RomainCocogne/POLYTECH_PEIP2_ARDUINO_PROJET/README.md

Polytech

Ce projet est réalisé dans le cadre de la formation de prépa intégrée de Polytech'Nice Sophia

# STROBOGLOVE
projet arduino time control glove 


<!--https://i.makeagif.com/media/1-31-2017/7Gys2-.gif pour une meilleur qualité mais qui marche pas avec l'HTML-->

## Présentation du projet
L'objectif de ce projet est de réaliser une paire de gants capable de "contrôler" le temps grâce à l'effet stroboscopique.

Voici un rendu du produit final: 

time control glove

## <a href="http://www.youtube.com/watch?feature=player_embedded&v=jR2pRvadDSw " target="_blank">Vidéo de démonstration du stroboglove</a>

***

Nous utilisons deux gants en communication bluetooth; l'un se charge des flashs lumineux et l'autre se charge du contrôle de la fréquence.

## Liste du matériel
### Structure 	
. Gants	Non payé
. Brassard	4.90
. Pâte thermique	5.24
. Lentilles optiques	2.82
. Plaque de cuivre	Non payé
### Electronique 	
. 2 Arduino (Nano/Mini Pro)	2x4.39
. Accéléromètre	Non payé
. Résistances 100 et 10k	Non payé
. MOSFET	0.93
. Flex Sensors	2x6.82
. LED blanche 100W	6.83
### Alimentation 	
. Batterie 11,1V - 12V +3A 1500 mAh	Non payé
. Batterie 8V	Non payé
. Convertisseur Boost DCDC (12V to 34V)	2.79
### Transfert de données :	
. Bluetooth HM-10	Non payé
### Objet en rotation	
. Moteur continu ou pas à pas	Non payé
. Horloge	Non payé
### TOTAL	45.93 €
