RomainCocogne/POLYTECH_PEIP2_ARDUINO_PROJET/doc/QuentinCOMBAL.md

# Cahier de suivi du projet de Quentin Combal

* ### Séance du 22 Décembre 2017 

Formation du groupe avec Romain Cocogne. Nous avions déjà prévu de faire un sujet mettant en scéne [*l'effet stroboscopique*](https://fr.wikipedia.org/wiki/Effet_stroboscopique).

L'effet stroboscopique est une illusion d'optique qui donne l'impression de ralentir, voire arreter complétement un objet en mouvement.

Aprés quelques recherches, nous nous sommes mis d'accord pour utiliser cet effet en le controllant à l'aide de deux gants.

* ### Séance du 12 Janvier 2018

Nous avons etabli une planification des taches sur un diagramme de Gantt. Nous avons egalement esquissé un schema de fonctionnement, et dréssé la liste des composants. 

* ### Séance du 18 Janvier 2018
Nous avons préparé la presentation orale de fin Janvier, envoyé une liste d'achat de composants à M.Masson, et réalisé un schema visuel de notre montage électronique avec le logiciel Fritzing. 
Nous avons également trouvé, dans les stocks de la salle elec, une batterie adéquate pour l'alimentation du premier gant.    

* ### Séance du 23 Janvier 2018
Nous avons présenté notre projet au groupe. 

* ### Séance du 7 Février 2018
Reçu les composants
Tests avec la LED : tension d'alimentation, luminosité, frequence de presistence retinienne.
Test des valeurs de resistance du flex sensor

* ### Entre le 7 Févrirer et le 16 Mars 2018
Mise en place du montage Arduino + DCDC Converter + LED. Tests avec ce montage pour determiner la bande de fréquences atteignable avec la LED.  

* ### Séance du 16 Mars 2018
Nous avons fait des tests avec l'accelerométre numérique et les modules bluetooth.
Nous avons également mis à jour notre diagramme de Gantt.

* ### Séance du 29 Mars 2018
Nous avons presenté notre avancement dans une presentation de mi-parcours. Nous avons egalement continué nos tests avec le bluetooth et l'accelerométre.

* ### Séance du 5 Avril 2018
Tests avec les flex sensors et les modules bluetooth. Finition du code pour l'accelerométre.

* ### Séance du 9 Avril 2018
Peaufinage du code comprenenant l'accelerométre, les flex sensors, et la LED. Debut d'un prototype avec le montage sur pcb du circuit de droite. Deuxiéme commande de composants.  

* ### Séance du 9 Mai 
Changment de matériel Bluetooth : On remplace les HC-05 par des HM-10 qui fonctionnement mieux 
Les codes des deux gants sont prets, il ne reste plus qu'a attendre les arduinos nano commandées et tout assembler.

* ### Du 21 au 31 Mai 
Assemblage et correction de quelques problémes de timing au niveau de libraries Arduino. Tournage de la vidéo de présentation.
