RomainCocogne/POLYTECH_PEIP2_ARDUINO_PROJET/doc/RomainCOCOGNE.md

# Cahier de suivi de projet Romain Cocogne

## Séance du 22 décembre

J'ai formé mon groupe avec Quentin Combal. Nous avons décidé de réaliser le **STROBOGLOVE**. Il s'agit d'une pair de gants qui donnent l'illusion de mannipuler le temps grâce à l'effet stroboscopique.

Nous avons trouvé un projet existant qui fonctionne sur un gant, mais nous avons décidé d'en faire une pair afin de respecter le cahier des charges (au moins une communication sans fil).

Lien vers le projet existant: http://www.instructables.com/id/DIY-Time-Control-Machine/ 

## Séance du 12 Janvier

Esquise du schémas électronique. J'ai commencé à lister les composants. On a hésité entre une arduino nano ou mini pro. On a aussi regardé si il était réalisable de n'utiliser qu'une seule arduino (au final c'est un peu dur).

## Séance du 18 Janvier

J'ai préparé le ppt de la présentation du 23 janvier. j'ai finalisé la liste des composants. Il ne reste plus qu'a l'envoyer à Mr Masson.

## Séance du 23 Janvier

On a fait la première présentation orale. On a réfléchit à des idées pour le réglage macro du stroboscope; L'idée retenue est utiliser les flex sensors pour régler en macro quand la main est fermée, sauf deux  doigts.

## Séance du 7 Février
On a reçus la majorité des composants.
On les a un peu testé notamment la LED et les flex sensors:
On a mesuré la consommation de la LED, les fréquences de fonctionnement.
On a mesuré les valeurs des flex sensors, tendus et pliés.

## Entre le 7 Févrirer et le 16 Mars
On a réalisé le montage de la main droite consistant à la batterie, la LED, et l'arduino. il ne reste plus que le module bluetooth sue cette main. On a testé les fréquences de fonctionnement de la LED et on a remarqué que le baud rate de l'arduino limitait la fréquence max de clignotement.  

## Séance du 16 Mars 
Quentin a travaillé sur l'accéléromètre, moi j'ai travaillé sur le bluetooth et j'ai essayé de le faire fonctionner. J'ai pris un HC-05 et un HC-06.
Nous avons également mis à jour notre diagramme de Gantt.

## Séance du 29 Mars
Nous avons presenté notre avancement dans une presentation de mi-parcours. J'ai continué de travailler sur le bluetooth. impossible de le faire fonctionner et je trouve pas la source du problème. Si cela continue je vais demander de l'aide à un professeur pour pouvoir avancer.

## Séance du 5 Avril
Quentin a fini de travailler sur l'accéléromètre. Je n'arrive toujours pas a faire fonctionner le bluetooth. On a aussi travaillé sur les flex sensors.

## Séance du 9 Avril
On a commandé de nouveaux composants. j'ai soudé le circuit de la main droite sur PCB.
On a travaillé sur des objets ludiques pour la démo.

## Séance du 2 Mai
J'ai demandé à Mr Ferrero de l'aide pour le bluetooth. Il m'a donné d'autres modules. Des HM-10. Ceux-ci ont l'air de marché, même si on s'est rendu compte qu'il s'agissait de contrefaçon. Je vais travailler avec ça maintenant.

## Séance du 9 Mai
On a avancé dans le montage final, même si on attend encore des composants clés (comme les arduino nano).
J'ai presque fini le code du bluetooth.

## Du 21 au 31 Mai
C'est le rush des dernières semaines. On a réussi à finir le hardware, malgré quelques problèmes au niveau des arduino nano (des contrefaçon). Il reste à corriger quelques bugs lociels et à préparer le rapport.
