RomainCocogne/POLYTECH_PEIP2_ARDUINO_PROJET/presentation/Presentation 2/Presentation_2.odt

Rappels sur le projet

Avancements :

la plupart des composants ont été reçus (Manque des flex sensors et les deux arduino nano)

La partie du montage qui contient la LED et complète et fonctionnelle. L'autre partie est

Les tests avec l'effet nous ont permis de définir les limites du projet (freq min et max, sur quels objets ? ) → Fréquence visible à l’œil nu : entre 70 Hz et 100Hz

→ 500Hz Max

Données du flex sensor, de la consommation du circuit.

Estimation de la durée de la batterie sans recharge (jusque là, pas eu besoin de recharger)

Réussites :

L'effet fonctionne, la mise en place est un succés

Mise en service des modules flex sensors et accelerométres reussie

Module bluetooth opérationnel, mais encore quelques complications

Difficultés :

Limitations d'arduino : Le Baud rate du bluetooth ( 250000 max) limite la fréquence à 500 Hz max

Difficulté a comprendre le code de l’accéléromètre : Filtre de Kalman, Bus I²C

Changements :

Trouver une bonne esthétique au produit.

On utilisera pas de potentiomètre, reglage en levant un ou deux doigts.On exploite les flex sensors

Dans le diagramme : Peaufinage des taches à venir, possibles car on s’était laissé de la marge , ajout de « l'étude des modules » comme tâche après avoir eu des difficultés → ça a pris du temps.

Objets ludiques : Horloge avec moteur

Batterie 2 : on a des candidats

Conclure sur le ressenti

Script :

Bonjour à tous, dans cette présentation nous allons vous montrer l'evolution de notre projet stroboglove.

Un petit rappel sur notre projet

L'etat d'avancement du projet : voici le schéma actuel. La partie droite est quasi-complète et fonctionne ( L'effet visuel est observable, la frequence est facilement manipulable). La partie gauche est déjà bien avancée (accélérométre + flex sensor OK). → Qu'est-ce qui ne fonctionne pas encore ?

Voici un exemple de rendu actuel en vidéo. L'effet n'est pas constant car perd en vitesse de rotation, objet pas suffisamment adapté mais l'effet est déjà bien visible.

Limitations : On a fait des tests des frequences min et max :

→ Visibilté à l'oeil nu : limite entre 70Hz et 100Hz

→ Limitations d'arduino : frequence max à 500Hz, on soupçonne que c'est dû au baud rate (utilisé pour le debug et le module bluetooth)

Données du flex sensor, de la consommation du circuit.

Estimation de la durée de la batterie sans recharge (jusque là, pas eu besoin de recharger)

Nos difficultés : étude des modules et des codes trouvés sur internet → Pas toujours facile

→ A posé des dificultés

ex : Filtre Kalman, récupérations des données de l’accéléromètre, modules bluetooth

Une mise à jour de notre matériel et de nos composants : En vert les composants que l'on à déjà, la majeure partie du matériel est déjà présente, il manque quelques flex sensors, la plaque de cuivre, etc... Plus de potentiomètre → on exploite les flex sensors.

Et il faudrait plus d'objets ludiques, par exemple une horloge mécanique à laquelle on fixerai un moteur pour faire tourner les aiguilles rapidement.

Nos objectifs principaux restent les mêmes : le fil rouge est toujours le même

Par contre, changements au niveau de l’esthétique et ergonomie : ajout de strips led comme indicateurs (pour le bluetooth, mode macro/micro, etc...)

Nous avons (peaufiné) notre diagramme de Gantt → les tâches jusqu'à aujourd'hui sont restées inchangées mais les tâches à venir ont été précisées suite à nos difficultées → « Étude des modules » par exemple

Changement possible car on s'est laissé de la marge.

Conclusion : notre ressenti, on est confiants pour la suite
