RomainCocogne/POLYTECH_PEIP2_ARDUINO_PROJET/presentation/Presentation finale/présentationfinale.pdf

# STROBOGLOVE

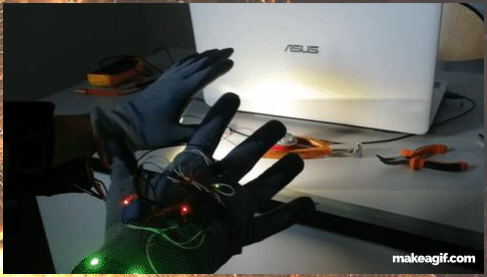
[picture p19: figure]

Polytech Nice-Sophia 2018

## COMBAL Quentin COCOGNE Romain

# sommaire

# •Objectifs du projet

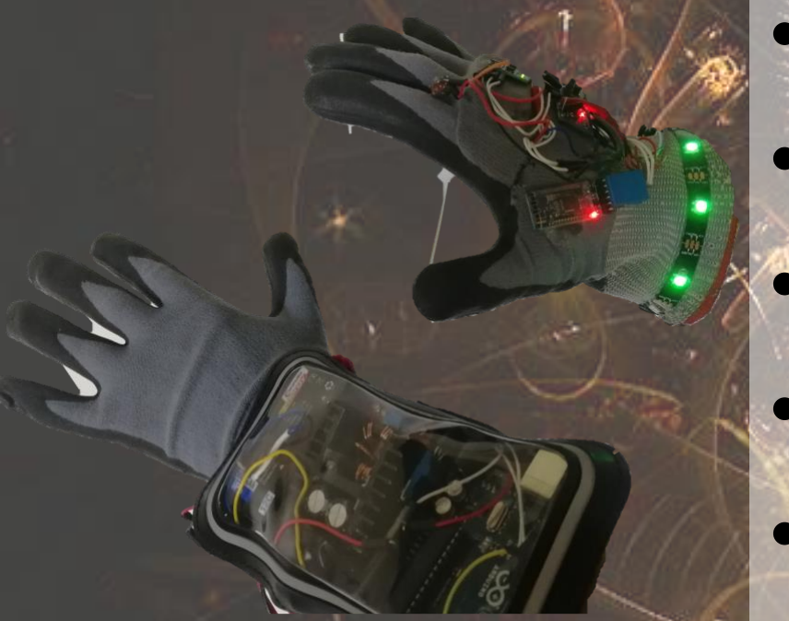
[picture p20: figure]

# - Principe de fonctionnement •Organisation du projet - Matériel et composants •Difficultés - Conclusion

# Objectifs

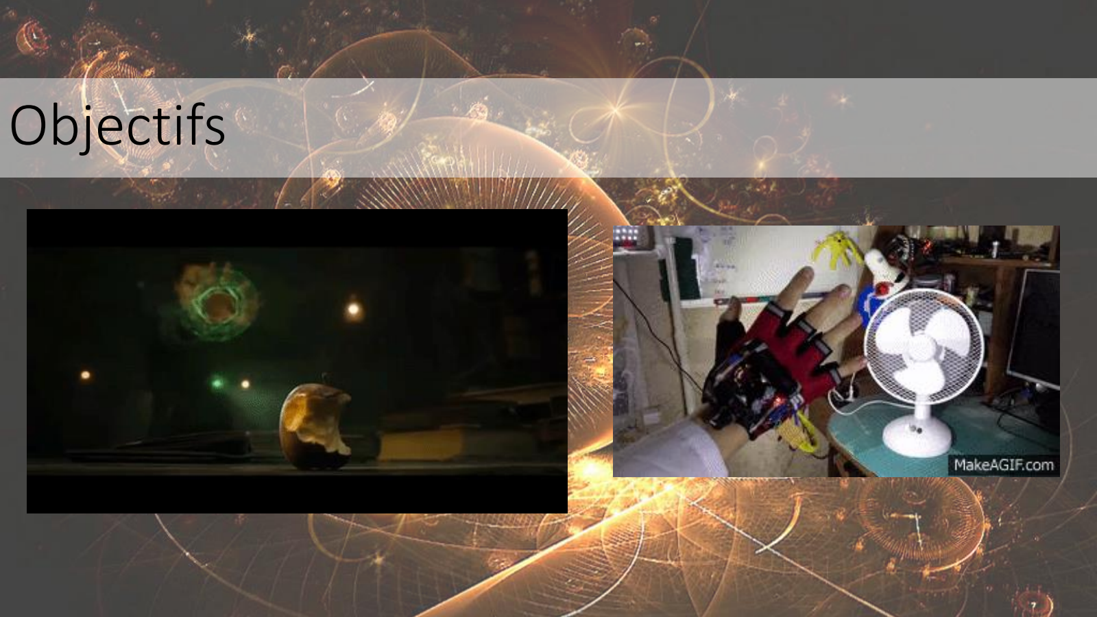
[picture p21: page 3]

# Rendu final

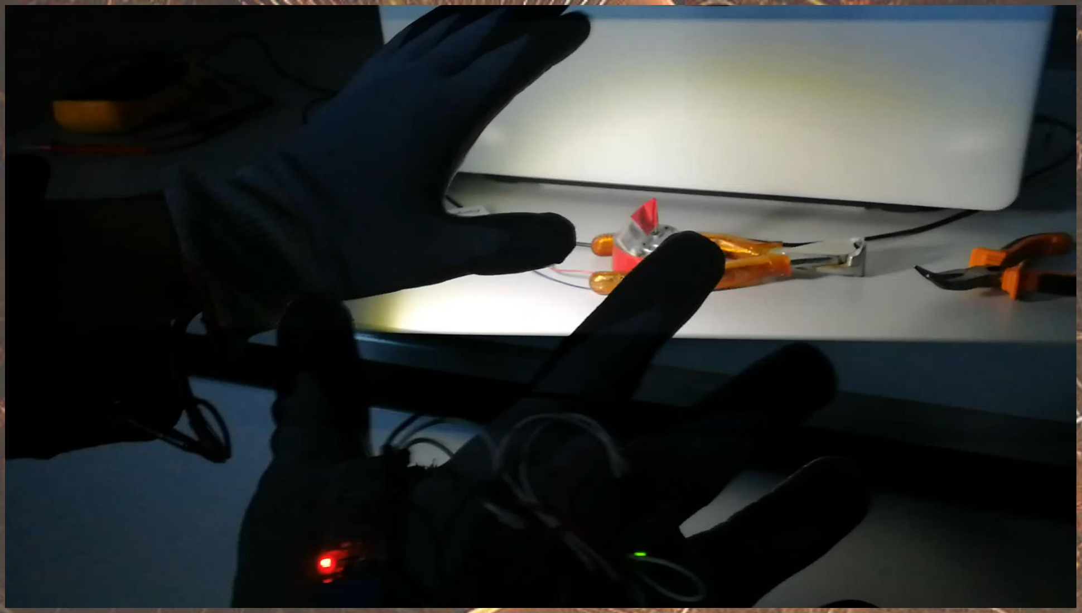
[picture p22: figure]

# Principe de fonctionnement

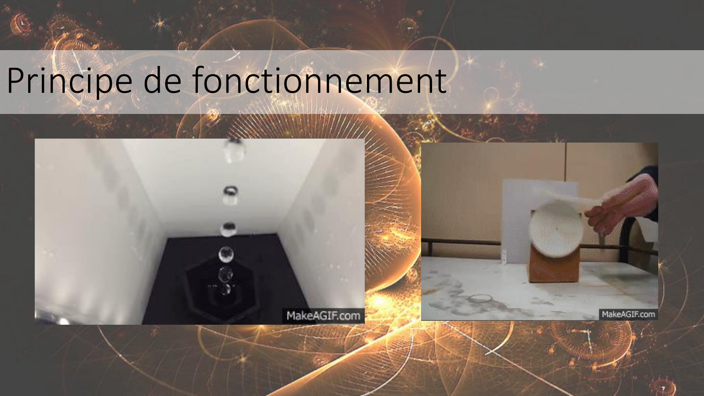
[picture p23: page 5]

# Principe de fonctionnement

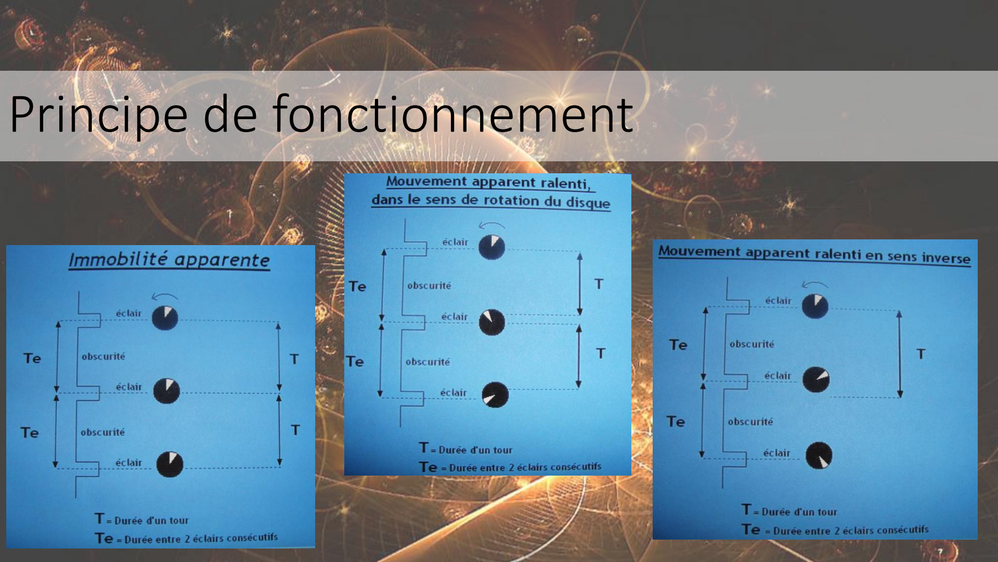
[picture p24: page 6]

# Organisation du projet

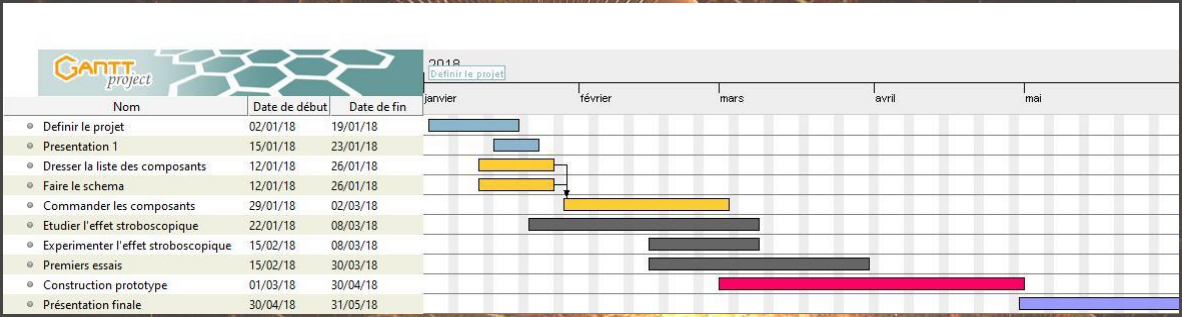
[picture p25: figure]

# Matériel et composants

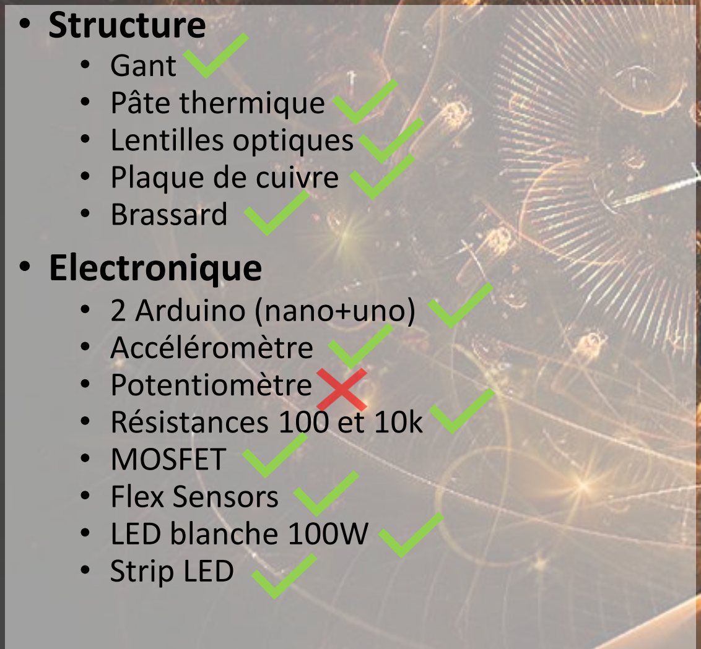
[picture p26: figure]
• Structure • Gant • Pâte thermique • Lentilles optiques • Plaque de cuivre • Brassard • Electronique • 2 Arduino (nano+uno) • Accéléromètre • Potentiomètre • Résistances 100 et 10k • MOSFET • Flex Sensors • LED blanche 100W • Strip LED
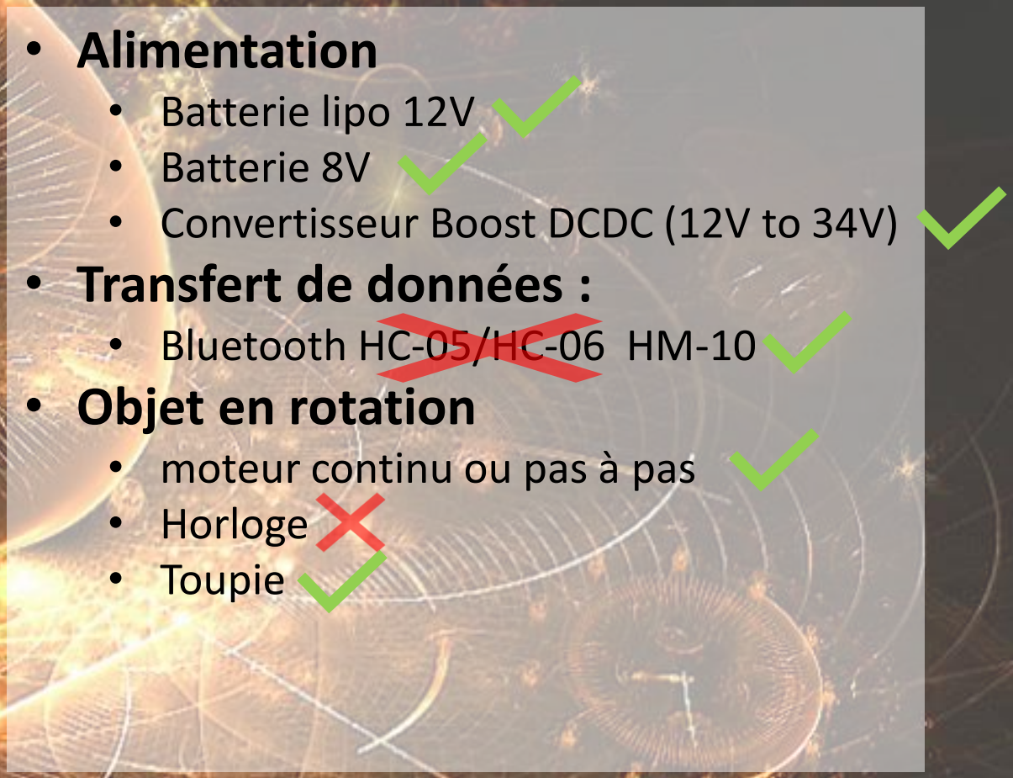
[picture p27: figure]
• Alimentation • Batterie lipo 12V • Batterie 8V • Convertisseur Boost DCDC (12V to 34V) • Transfert de données : • Bluetooth HC-05/HC-06 HM-10 • Objet en rotation • moteur continu ou pas à pas • Horloge • Toupie

# Schéma

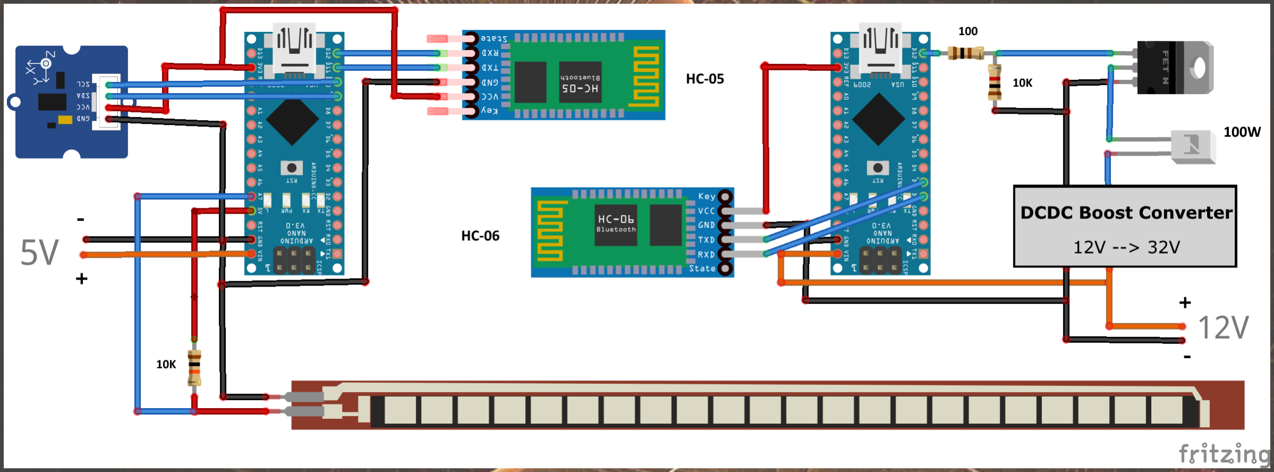
[picture p28: figure]

# Difficultés

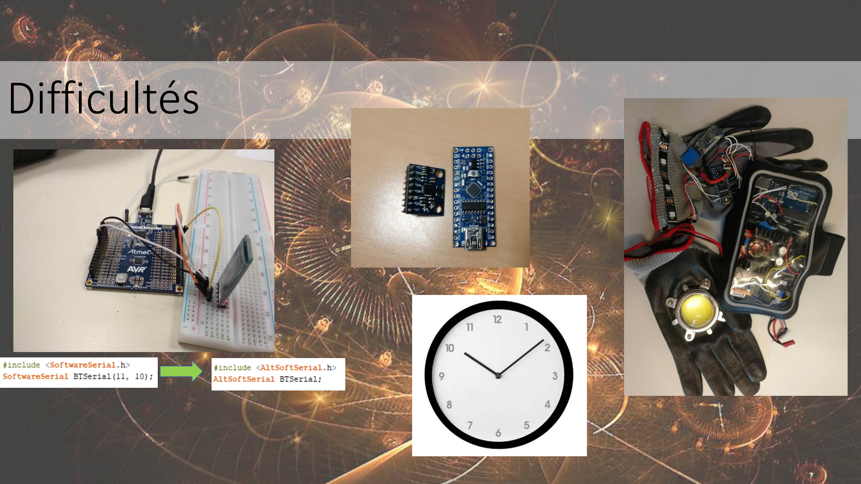
[picture p29: page 10]

# Conclusion

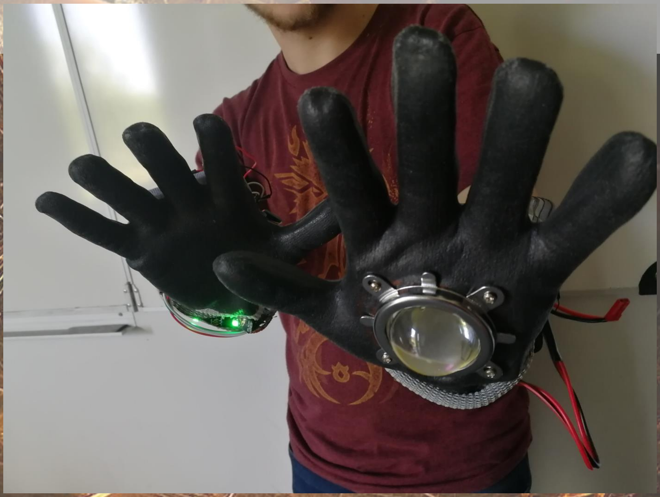
[picture p30: figure]

## - http://lesillusionsdoptique-tpe.e-monsite.com/pages/la-

stroboscopie-qu-est-ce-que-c-est.html (http://lesillusionsdoptique-tpe.e-monsite.com/pages/la-stroboscopie-qu-est-ce-que-c-est.html)

## - http://www.makeagif.com - http://www.instructables.com/id/DIY-Time-Control-Machine/

# Sources
