RomainCocogne/POLYTECH_PEIP2_ARDUINO_PROJET/presentation/Presentation 2/présentation2.pdf

STROBOGLOVE | Présentation mi-parcours

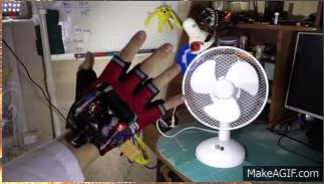
[picture p31: figure]

Polytech Nice-Sophia 2018

## COMBAL Quentin COCOGNE Romain

# Rappel du projet

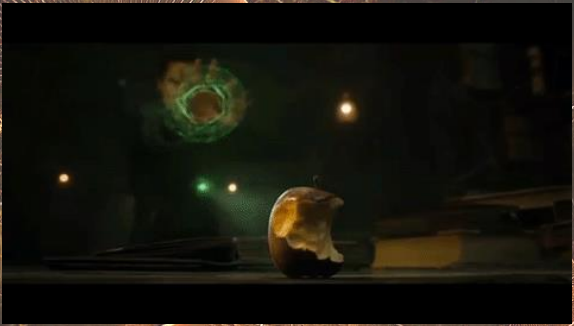
[picture p32: figure]

# sommaire

# - Avancement, réussite et difficulté - Matériel - Changement des objectifs - Retour sur planning

# Avancement, réussite et difficulté


# Avancement, réussite et difficulté

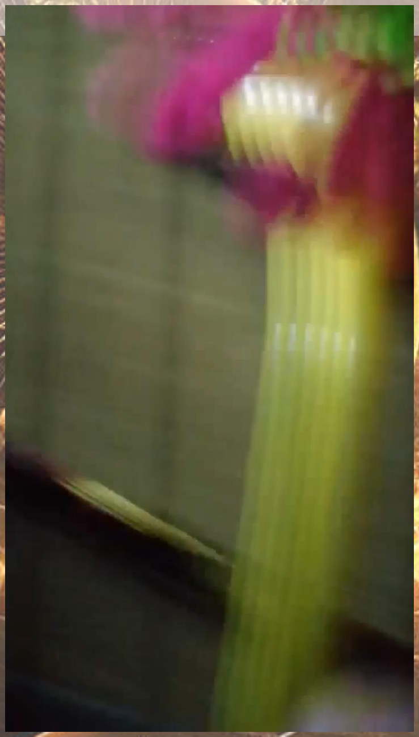
[picture p33: figure]

# Avancement, réussite et difficulté

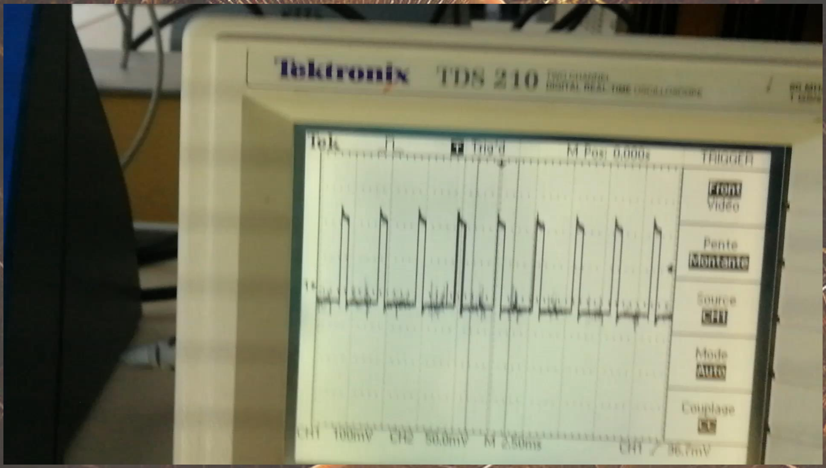
[picture p34: figure]

# Avancement, réussite et difficulté

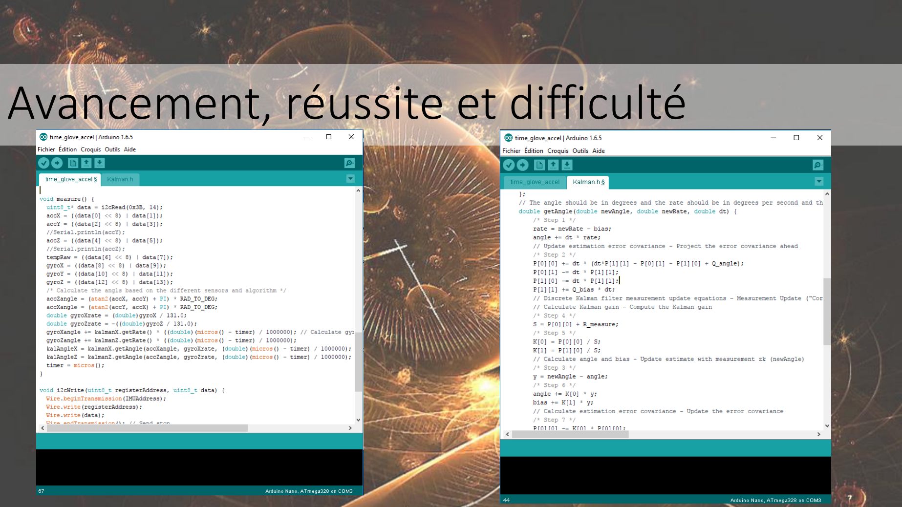
[picture p35: page 7]

### - Structure

- Gant
- Pâte thermique
- Lentilles optiques
- Plaque de cuivre

### - Electronique

- 2 Arduino (Nano/Mini Pro)
- Accéléromètre
- Potentiomètre
- Résistances 100 et 10k
- MOSFET
- Flex Sensors
- LED blanche 100W
- (LED couleur)

# Matériel et composants

### - Alimentation

- Batterie lipo 11,1V - 12V +3A 1500 mAh
- 2éme (batterie moins puissante)
- Convertisseur Boost DCDC (12V to 34V)

### - Transfert de données :

- HC-05 et HC-06

### - Objet en rotation

- moteur continu ou pas à pas
- Horloge
- Toupie

# Changement des objectifs

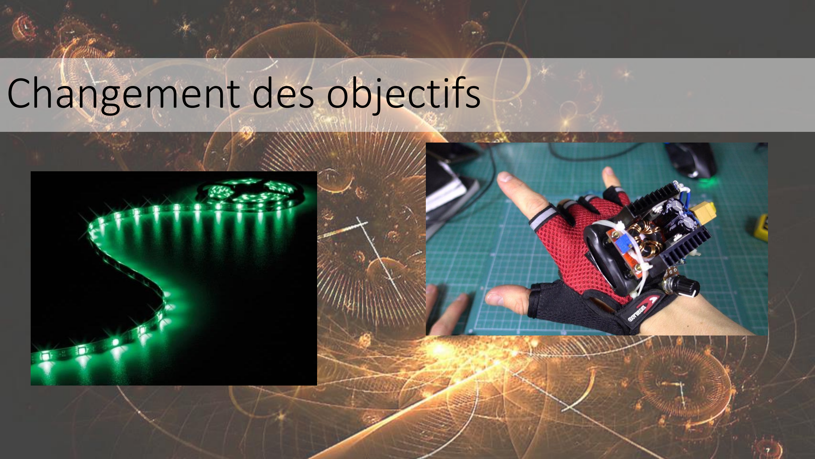
[picture p36: page 9]

# Organisation du projet

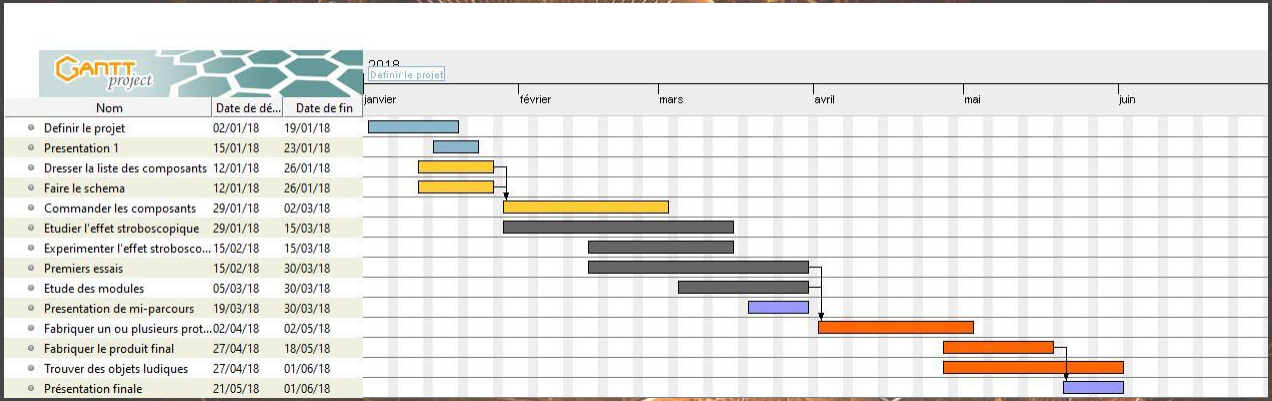
[picture p37: figure]
