RomainCocogne/POLYTECH_PEIP2_ARDUINO_PROJET/presentation/Presentation 1/présentation1.pdf

# STROBOGLOVE


Polytech Nice-Sophia 2018

## COMBAL Quentin COCOGNE Romain

# sommaire

# - Pourquoi ce projet ? - Principe de fonctionnement - Matériel et composants •Organisation du projet - Conclusion

# Pourquoi ce projet ?

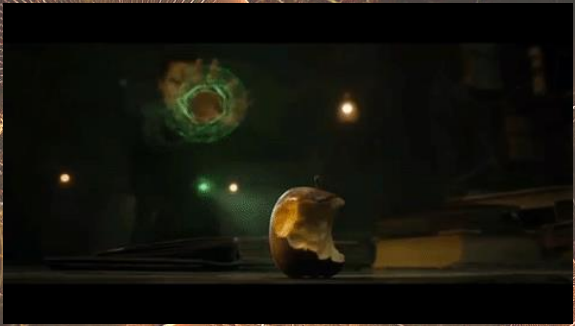
[picture p38: figure]

# Principe de fonctionnement


# Principe de fonctionnement


# Principe de fonctionnement


### - Structure

- Gant
- Pâte thermique
- Lentilles optiques
- Plaque de cuivre

### - Electronique

- 2 Arduino (Nano/Mini Pro)
- Accéléromètre
- Potentiomètre
- Résistances 100 et 10k
- MOSFET
- Flex Sensors
- LED blanche 100W

# Matériel et composants

### - Alimentation

- Batterie lipo 11,1V - 12V +3A 1500 mAh OK
- 2éme (batterie moins puissante)
- Convertisseur Boost DCDC (12V to 34V)

### - Transfert de données :

- Bluetooth

### - Objet en rotation

- moteur continu ou pas à pas
- objet ludique
- Horloge
- Toupie

# Organisation du projet


# Conclusion

https://youtu.be/rj9L1_-AzMc?t=19s

## - http://lesillusionsdoptique-tpe.e-monsite.com/pages/la-

stroboscopie-qu-est-ce-que-c-est.html (http://lesillusionsdoptique-tpe.e-monsite.com/pages/la-stroboscopie-qu-est-ce-que-c-est.html)

## - http://www.makeagif.com

# Sources
