RomainCocogne/POLYTECH_PEIP2_ARDUINO_PROJET/presentation/Presentation finale/PresentationFinale.odt

Explication du projet : Objectifs, motivations,...

Expliquer notre avancement final par rapport au planning prévu

Comparaison rendu attendu / rendu final. Gif de la vidéo qu'on a pris

Explication du principe et des rôles de chaque gant.

Description des fonctionnalités : Modes Macro/Micro, communication bluetooth, Strips LEDs indicatives, stabilité de la frequence grace à Kalman, activation grace à un mouvement de la main

Parler des limites de frequence

Résume du materiel, explication du rôle de chaque composant

Resumer l'ordre d'acquisition des composants ?

Dire quels composants ont été changés (HC-06 en HM-10, Arduino Nano en Uno)

Explication du schéma

Explication des difficultés : Exploitation de l'accelerométre, du filtre de Kalman, problémes avec les modules bluetooth, problémes avec la library Software Serial,, probléme de la nano defectueuse, probléme d'espace sur le gant

Perspectives : Ce qui reste à faire, ce qu'il faudrait ajouter ou améliorer (améliorer l'aspect visuel en camouflant les composants et fils, trouver des meilleures batteries, idée de la maille de piles plates, amélioration du confort utilisateur)

Ce que nous aurions aimer faire (l'horloge rapide pour objet ludique)

On aimerait pouvoir garder les gants pour les améliorer de notre coté

Utilisation de l'objet à des fins divertissantes ou scientifiques

Conclusion : Ce que ce projet nous a appris

Script :

Bonjour à tous, aujourd'hui nous allons vous présenter notre projet qui s'intitule StroboGlove. Nous allons vous parler de son développement, et nous allons vous présenter le produit final.

Nous allons d'abord vous parler de l'idée et des objectifs de notre projet, ensuite nous vous expliqueront le principe de fonctionnement, nous dresserons le matériel et nous détaillerons le rôle de chaque composant, enfin nous vous parlerons des difficultés rencontrées et de ce que nous a appris ce projet.

Tout d'abord, d'où nous est venu l'idée de ce projet ? Elle vient de cette scène de docteur strange, nous voulions recréer l'effet en vrai. Nous sommes tombés sur cette vidéo youtube qui exploitait l'effet Stroboscopique. Nous avons donc pensé à utiliser le même principe pour notre projet, mais en personnalisant le design et en ajoutant des fonctionnalités.

Voici donc le rendu final de notre projet

Parler des différentes fonctionnalités : Deux gants, Strip LEDs, Deux modes de reglages en pliant les doigts

Transistion : Ce projet se base donc sur l'effet stroboscopique

Reexpliquer ce qu'est l'effet Stroboscopique

Expliquer le rôle de chaque gant, les personnalisations que l'on a apportées

Transistion : Ce projet a demandé une organisation considérable, voici comme nous avons planifié les différentes tâches

Parcourir le diagramme en expliquant les différentes étapes

Transition : On vous a parlé de la liste des matériaux, la voici

Parcourir la liste des matériaux en expliquant leur rôle

Et voici le schéma fonctionnel du projet

Résumer les rôles de chaque partie du schéma. Expliquer quel composant va où

Expliquer les changements de certains composants

Transition : Certains composants ont été sources de problèmes et de difficultés

Tout d'abord avec une Arduino Nano probablement défectueuse, après avoir passé plusieurs jours a essayer de la faire fonctionner, il a fallu en recuperer une autre en urgence

Tout comme les HC-06, impossible de les faire fonctionner correctement → Remplacés par des HM-10

pb de place (brassard)

Manque d'objets ludiques malgré nos efforts pour confectionner une horloge qui tourne vite

Enfin, des difficultés sur le plan logiciel : Exploitation des données de l’accéléromètre, filtre de Kalman, problémes de stabilité dus à la Library Software Serial

Transition : Mais au final, nous avons su faire face aux difficultés et nous avons pu résoudre la majorité de nos problèmes

Conclusion : Ce qu'on a appris , les améliorations qu'on aimerait faire (confort, gestion de l'espace, design, meilleure alimentation, circuit imprimé souple) et pourquoi on aimerait le projet
